kirtonBCIlab/boccia-hardware-firmware/(threads)

Thread 13 (2023-05-05):

Force sensor

danielcomaduran, 2023-05-05:
Mount force sensor on the bottom of the ramp. Use a foam-like material that can deform a little bit before mechanical failure occurs.

Thread 14 (2023-05-05):

Release mount redesign

danielcomaduran, 2023-05-05:
Redesign the holder for the release mechanism so that it can house one optical sensor at the lower end

Thread 15 (2023-05-05):

Multiple sensors

danielcomaduran, 2023-05-05:
Modify the stepper motor object so that we can use two separate sensors for the calibration. This would allow us to know which side is activated. Make sure that the implementation still makes use of the interrupts

Closed 2023-07-24.

Thread 17 (2023-05-05):

Change base for hard wood

danielcomaduran, 2023-05-05:
Or add some support material so that the wood doesn't deform because of the tension caused by the belt attached to the rotation motor

Thread 18 (2023-05-05):

Release mechanism

danielcomaduran, 2023-05-05:
Write a method in the stepper motor that controls the mechanism to open the lever. The lever should have an optical sensor on the lower side before mechanical failure. The movement flow should be as follows:

- Have the lever move until the sensor is active, this will be set to position 0.
- When the respective serial command is received, have the motor move `x` number of steps up to allow the ball to drop.
- Return the motor to the 0 position.
- Make sure that x is an input variable to the method so that it can be adjusted by trial and error

Closed 2023-07-20.

Thread 9 (2023-05-05):

Variable to set correct direction of linear actuators

danielcomaduran, 2023-05-05:
The linear actuators are soldered in different orientations (i.e., one extends with the same command that retracts the other). This is due to the cabling of the driver being reversed. Create an attribute in the linear actuator object that addresses this issue

Thread 25 (2023-05-25):

Incline actuator extending too much

danielcomaduran, 2023-05-25:
The way that the incline actuator is mounted right now, it can extend to a point where the front of the ramp will hit the floor

Closed 2023-07-24.

Thread 31 (2023-06-30):

Update schematic with LPF

danielcomaduran, 2023-06-30:
Update the schematic files to include the low-pass filter that was added to the optical sensors.
Values for the filter are: 15 kOhms y 1 nF

Closed 2023-07-13.

Thread 37 (2023-07-14):

Sensor test

danielcomaduran, 2023-07-14:
Sensor is moved to analog pin 7, do not use interrupt any more.

Muhammad
- Do a test function to read the value of the pressure sensor and print in Serial

Dan
- In main code do this: check for sensor analog value while moving motor, if threshold is passed, stop movement and return a bit

Closed 2023-07-20.

Thread 39 (2023-07-20):

Skipping Steps

MuhammadFAns, 2023-07-20:
Both motors are skipping steps

Closed 2023-07-31.

Thread 42 (2023-07-24):

Pressure sensor hold mechanism

danielcomaduran, 2023-07-24:
The foam used to secure the pressure sensor to the bottom of the ramp is too wide, if the ramp does not contact the ground right under the sensor, the foam deforms but the sensor does not get activated. Some solutions are:
1. Change the foam for a narrower foam that just covers the sensor and not the whole back of the ramp
2. Design a completely new mechanism to secure the pressure sensor to the ramp.

Thread 43 (2023-07-24):

Redo incline motor attachment mechanism

danielcomaduran, 2023-07-24:
With the current mechanism,
1. The incline motor can continue to push after the ramp has touched the ground; the 3D printed parts deform, and the motor pushed backwards instead of upwards.
2. The ramp has a lot of play to the sides

Thread 45 (2023-07-24):

Fix the return steps for BocciaStepper()

danielcomaduran, 2023-07-24:
Fix the return steps so that it automatically clears the sensor, instead of having to use the `nsteps_return` attribute.

danielcomaduran, 2023-08-01:
I tried this and it does not work. The problem is that since the motor only takes one step at a time, the movement is quite slow and it doesn't seem smooth. It is better to keep the `nsteps_return` option.

Closed 2023-08-01.

Thread 63 (2024-03-01):

Change linear actuator to control to PID controller

danielcomaduran, 2024-03-01:
Change the current controller method of the linear actuators to use a PID controller.

Here is one starting point:
```
// Define your tuning parameters (you can adjust these)
double kp = 0.1; // Proportional gain
double ki = 0.01; // Integral gain
double kd = 0.001; // Derivative gain

// Initialize variables
unsigned long lastTime = 0;
double Input = 0.0; // Sensor input (e.g., temperature, position)
double Output = 0.0; // Control output (e.g., motor speed)
double Setpoint = 100.0; // Desired setpoint (adjust as needed)
double errSum = 0.0; // Integral term
double lastErr = 0.0; // Previous error

void Compute() {
    // Calculate time since last computation
    unsigned long now = millis();
    double timeChange = (double)(now - lastTime);

    // Compute error terms
    double error = Setpoint - Input;
    errSum += (error * timeChange);
    double dErr = (error - lastErr) / timeChange;

    // Compute PID output
    Output = kp * error + ki * errSum + kd * dErr;

    // Remember variables for next iteration
    lastErr = error;
    lastTime = now;
}

void SetTunings(double Kp, double Ki, double Kd) {
    // Set new tuning parameters
    kp = Kp;
    ki = Ki;
    kd = Kd;
}

void setup() {
    // Initialize your hardware (e.g., sensors, actuators)
    // Set initial setpoint and other parameters
}

void loop() {
    // Read sensor input (e.g., analogRead, digitalRead)
    Input = /* Read your sensor value here */;

    // Compute PID output
    Compute();

    // Apply the control output (e.g., analogWrite, digitalWrite)
    // Adjust your motor speed or other actuator accordingly
}
```
