kirtonBCIlab/boccia-hardware-firmware/Electronics/Boccia-controller/controller.sch

## EAGLE design Electronics/Boccia-controller/controller.sch (2023-07-13)

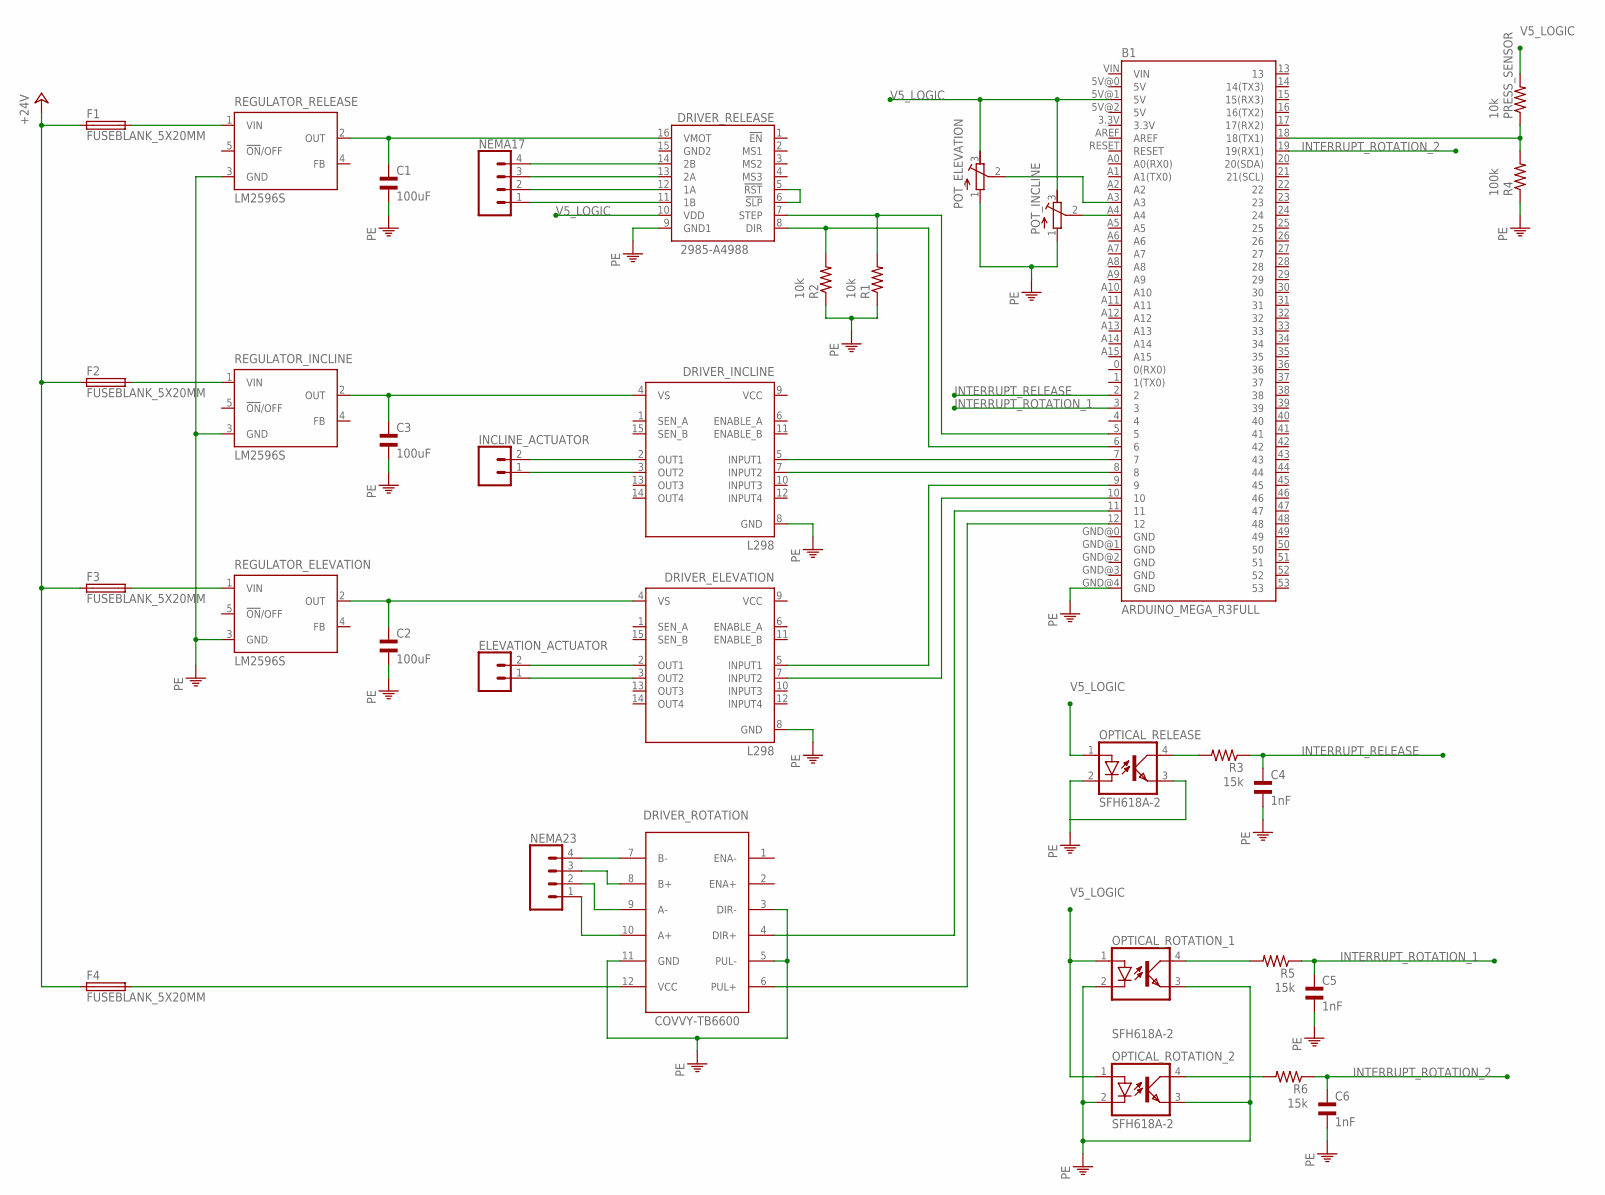
[picture p1: schematic controller.sch]

Parts:
B1: ARDUINO_MEGA_R3FULL; ARDUINO_MEGA
C1, C2, C3: 100uF; EU35-12
C4, C5, C6: 1nF; EU35-12
DRIVER_ELEVATION: L298; MULTIWATT-15
DRIVER_INCLINE: L298; MULTIWATT-15
DRIVER_RELEASE: 2985-A4988; A4988
DRIVER_ROTATION: COVVY-TB6600; COVVY_TB6600
ELEVATION_ACTUATOR: CONN_02; 1X02
F1, F2, F3, F4: FUSEBLANK_5X20MM; FUSE_HOLDER_5X20MM
INCLINE_ACTUATOR: CONN_02; 1X02
NEMA17, NEMA23: CONN_04; 1X04
OPTICAL_RELEASE: SFH618A-2; DIP4
OPTICAL_ROTATION_1, OPTICAL_ROTATION_2: SFH618A-2; DIP4
POT_ELEVATION: R-TRIMM64X; RTRIM64X
POT_INCLINE: R-TRIMM64X; RTRIM64X
PRESS_SENSOR: 10k; R0805
R1, R2: 10k; R0805
R3, R5, R6: 15k; R0805
R4: 100k; R0805
REGULATOR_ELEVATION: LM2596S; TO263-5
REGULATOR_INCLINE: LM2596S; TO263-5
REGULATOR_RELEASE: LM2596S; TO263-5

Connections:
+24V: F1.1, F2.1, F3.1, F4.1
INTERRUPT_RELEASE: B1.2, C4.1, R3.1
INTERRUPT_ROTATION_1: B1.3, C5.1, R5.1
INTERRUPT_ROTATION_2: B1.19 (19(RX1)), C6.1, R6.1
unnamed: B1.18 (18(TX1)), PRESS_SENSOR.1, R4.2
unnamed: DRIVER_ROTATION.7 (B-), NEMA23.4
unnamed: DRIVER_ROTATION.8 (B+), NEMA23.3
unnamed: DRIVER_ROTATION.9 (A-), NEMA23.2
unnamed: DRIVER_ROTATION.10 (A+), NEMA23.1
unnamed: F2.2, REGULATOR_INCLINE.1 (VIN)
unnamed: B1.A3, POT_ELEVATION.2 (S)
unnamed: B1.A4, POT_INCLINE.2 (S)
unnamed: DRIVER_ELEVATION.2 (OUT1), ELEVATION_ACTUATOR.2
unnamed: DRIVER_ELEVATION.3 (OUT2), ELEVATION_ACTUATOR.1
unnamed: DRIVER_INCLINE.2 (OUT1), INCLINE_ACTUATOR.2
unnamed: DRIVER_INCLINE.3 (OUT2), INCLINE_ACTUATOR.1
unnamed: C2.1, DRIVER_ELEVATION.4 (VS), REGULATOR_ELEVATION.2 (OUT)
unnamed: C3.1, DRIVER_INCLINE.4 (VS), REGULATOR_INCLINE.2 (OUT)
unnamed: DRIVER_RELEASE.14 (2B), NEMA17.4
unnamed: DRIVER_RELEASE.13 (2A), NEMA17.3
unnamed: DRIVER_RELEASE.12 (1A), NEMA17.2
unnamed: DRIVER_RELEASE.11 (1B), NEMA17.1
unnamed: DRIVER_RELEASE.5 (!RST), DRIVER_RELEASE.6 (!SLP)
unnamed: B1.10, DRIVER_ELEVATION.7 (INPUT2)
unnamed: B1.9, DRIVER_ELEVATION.5 (INPUT1)
unnamed: B1.8, DRIVER_INCLINE.7 (INPUT2)
unnamed: B1.7, DRIVER_INCLINE.5 (INPUT1)
unnamed: B1.6, DRIVER_RELEASE.8 (DIR), R2.2
unnamed: B1.5, DRIVER_RELEASE.7 (STEP), R1.2
unnamed: OPTICAL_RELEASE.4 (COL), R3.2
unnamed: F1.2, REGULATOR_RELEASE.1 (VIN)
unnamed: DRIVER_ROTATION.12 (VCC), F4.2
unnamed: F3.2, REGULATOR_ELEVATION.1 (VIN)
unnamed: OPTICAL_ROTATION_1.4 (COL), R5.2
unnamed: OPTICAL_ROTATION_2.4 (COL), R6.2
unnamed: B1.11, DRIVER_ROTATION.4 (DIR+)
unnamed: B1.12, DRIVER_ROTATION.6 (PUL+)
PE: B1.GND@4 (GND), C1.2, C2.2, C3.2, C4.2, C5.2, C6.2, DRIVER_ELEVATION.8 (GND), DRIVER_INCLINE.8 (GND), DRIVER_RELEASE.9 (GND1), DRIVER_ROTATION.3 (DIR-), DRIVER_ROTATION.5 (PUL-), DRIVER_ROTATION.11 (GND), OPTICAL_RELEASE.2 (C), OPTICAL_RELEASE.3 (EMIT), OPTICAL_ROTATION_1.2 (C), OPTICAL_ROTATION_1.3 (EMIT), OPTICAL_ROTATION_2.2 (C), OPTICAL_ROTATION_2.3 (EMIT), POT_ELEVATION.1 (A), POT_INCLINE.1 (A), R1.1, R2.1, REGULATOR_ELEVATION.3 (GND), REGULATOR_INCLINE.3 (GND), REGULATOR_RELEASE.3 (GND)
V5_LOGIC: B1.5V@1 (5V), DRIVER_RELEASE.10 (VDD), OPTICAL_RELEASE.1 (A), OPTICAL_ROTATION_1.1 (A), OPTICAL_ROTATION_2.1 (A), POT_ELEVATION.3 (E), POT_INCLINE.3 (E), PRESS_SENSOR.2
V12_NEMA17: C1.1, DRIVER_RELEASE.16 (VMOT), REGULATOR_RELEASE.2 (OUT)
