kirtonBCIlab/boccia-hardware-firmware/Stepper_feedback_control/Stepper_feedback_control.ino

/*
 * Stepper Feedback Control
 */


// Sensor variables
const int pin_sense = A0;
const float analog_threshold = 2; // Analog reading threshold [V]
bool limit_trigger = 0;

// Stepper motor variables
#include <AccelStepper.h>

const int pin_dir = 3;  // Direction pin
const int pin_step = 2; // Step pin
int lim0;               // Lower limit of the stepper motor [steps]
int lim1;               // Higher limit of the stepper motor [steps]
int range;              // Range of movement of the stepper [steps]

// - Create stepper object
AccelStepper nema8(AccelStepper::DRIVER, pin_step, pin_dir);

void setup() {
  Serial.begin(9600);

  // Set stepper parameters
  nema8.setMaxSpeed(1000);    // Maximum speed [steps/sec]
  nema8.setAcceleration(10);  // Acceleration [steps/sec^2]
  nema8.setSpeed(400);        // Speed [steps/sec]
  range = 0;                  // Range of motion of calibrated motor [steps]

  Serial.println("Select command:\n - c: calibration\n - m: move");
}

void loop() {
  if(Serial.available() > 0)
  {
    char answer = Serial.read();
    
    // Flush buffer
    for(int i=0; i<Serial.available(); i++)
    { Serial.read();  }
    
    
    if(answer=='c')
    {
      calibrationProcess();
      Serial.println("Select 'm' to move");
    }
    else if(answer=='m')
    {
      Serial.println("How many steps to move?");

      while(Serial.available()<=1)
      {
        waitMillis(100);
      }
      int steps = Serial.parseInt();
      moveProcess(lim0, lim1, steps); 
    }
    else
    {}
  }
  


}

// Move stepper only within limits
void moveProcess(int lim0, int lim1, int move_steps)
{
  int current_position = nema8.currentPosition();
  Serial.println("Current pos: " + String(current_position));
  Serial.println("How many steps requested? " + String(move_steps));
  int new_position = current_position + move_steps;
  Serial.println("Calculated new pos: " + String(new_position));

  if((new_position < lim0) && (new_position > lim1))
  {
    moveStepper(move_steps);
  }
  else if (new_position > lim0)
  {
    move_steps = lim0 - current_position;
    moveStepper(move_steps);
  }
  else if (new_position < lim1)
  {
    move_steps = lim1 - current_position;
    moveStepper(move_steps);
  }
  else
  {
    Serial.println("No need to move, already at limit!");
  }
  Serial.println("Actual position after movement " + String(nema8.currentPosition()));
}

void calibrationProcess()
{
  Serial.println("Calibration started");
  
  waitMillis(1000);
  lim0 = calibrateStepper(1);
  Serial.println("Lower limit found");
  Serial.println("Stepper position: " + String(lim0));
  
  waitMillis(1000);  
  lim1 = calibrateStepper(-1);
  Serial.println("Upper limit found");
  Serial.println("Stepper position: " + String(lim1)); 

  Serial.println("Range: " + String(abs(lim1-lim0)));
  Serial.println("Calibration finished\n");
}

// Calibrate stepper motor and return position 
int calibrateStepper(int stepper_direction)
{
  float analog_value;
  do
  {
    nema8.move(5*stepper_direction);
    nema8.run();
    analog_value = analogReader(pin_sense);
  }while(analog_value < analog_threshold);

  int stepper_lim = nema8.currentPosition();
  return stepper_lim;
}

void moveStepper(int steps)
{
  nema8.move(steps);
  while(nema8.distanceToGo() != 0)
  {    
    nema8.run();
  }
}

// Read analog pin and convert to V
float analogReader(int analog_pin)
{
  float analog_digital = analogRead(analog_pin);
  float analog_volts = analog_digital * 5 / 1024;
  return analog_volts;
}

void waitMillis(unsigned long wait_msec)
{
    unsigned long deltaT, t0, t1 = 0;
    t0 = millis();
    
    do
    {
      t1 = millis();
      deltaT = t1-t0;
    }while(deltaT < wait_msec);
}
