kirtonBCIlab/boccia-hardware-firmware/Examples/LED_test/LED_test.ino

void setup() {
  // Initialize LEDs
  pinMode(3, OUTPUT);
  pinMode(LED_BUILTIN, OUTPUT);

}

void loop() {
  digitalWrite(LED_BUILTIN, HIGH);   // turn the LED on (HIGH is the voltage level)
  delay(2000);                       // wait for a second
  digitalWrite(LED_BUILTIN, LOW);    // turn the LED off by making the voltage LOW
  delay(1000);                       // wait for a second

  digitalWrite(3, HIGH);   // turn the LED on (HIGH is the voltage level)
  delay(1000);                       // wait for a second
  digitalWrite(3, LOW);    // turn the LED off by making the voltage LOW
  delay(1000);                       // wait for a second

}
