kirtonBCIlab/boccia-hardware-firmware/(commit log)

2022-07-20 Create LED_test.ino
    Simple script to turn built-in and external LEDs
2022-08-04 Uploaded sketch for actuator simple control
2022-08-11 Uploaded sketch for stepper motor without libraries
2022-08-12 Uploaded simple controller for stepper motor
2022-08-17 Sketch to control the stepper through serial communication
2022-08-18 Uploaded stepper feedback sketch
    Sketch that allows for calibration of the stepper motor using the optical sensor. Then one can input how many steps to move within the calibrated range
2022-09-15 OOD Example
    Uploaded initial commit for Object Oriented Example with Interrupts working
2022-09-22 implemented interrupt limit for decceleration
2022-09-22 Added calibration prints
2022-10-03 Small tweaks on linear stepper
2022-10-27 Added conversion between percentage and resistance
2022-10-28 Added error message for wrong command
    [main.cpp]
2022-10-28 Fixed motor selection
2022-11-04 Fixed bug linear actuator over limits
    [main.cpp]
2022-11-04 Implement acceleration on linear actuator
2022-12-13 Created folders and files for mixed motor
2022-12-13 Changed pin to potentiometer and added sensor variable
2022-12-14 Added warning to actuator movement over or under limits
2022-12-14 Digital debounce func and calibration with sensor
2022-12-21 Added elevator actuator object
2022-12-21 Changed direction of motors
2022-12-21 Added elevator actuator
2023-02-28 Deleted repeated elevator actuator
2023-02-28 Changed name of motors and minor fixes
    [main.cpp]
2023-04-17 Minor comments to fix
    [main.cpp]
2023-05-17 Added a few lines of description to Boccia stepper
2023-06-16 Uploaded electronics schematics
    [controller.sch]
2023-06-16 Added test sketch for testing the linear actuators
2023-06-16 Changed incline pot pin value
2023-06-16 Updated calibration test sketch
2023-06-16 Added check for sensor to fix calibration
2023-06-16 Updated electronics schematics
    [controller.sch]
2023-06-30 Added pin number
2023-06-30 check point with errors
    [main.cpp]
2023-07-04 Implemented OOP for stepper
2023-07-11 Save point, issue with release interrupts
    [Stepper_feedback_interrupt_control.ino, Stepper_library_hello_world.ino, main.cpp]
2023-07-12 Check point not working
    [Stepper_feedback_interrupt_control.ino, main.cpp]
2023-07-13 Modified example file to test stepper motors
2023-07-13 Updated new files with filters for optical sensors
    [controller.sch]
2023-07-13 Checkpoint without the optical sensors enabled
2023-07-13 Stepper OOP finished with sensor
2023-07-18 Release Sensor
2023-07-19 Checkpoint with actuators working
2023-07-19 Linear actuators working
2023-07-19 Uncommented calibrations
2023-07-19 CHeck point, release mechanism not working
    [main.cpp]
2023-07-20 Changed functions slightly for interrupt
2023-07-20 Changes direction when sensor is active
2023-07-20 Added movement if sensors blocked
2023-07-24 Clear Sensor Added to Code
2023-07-24 Added the gear_ratio attribute to BocciaStepper
2023-07-25 Not working, some notes added
    [main.cpp]
2023-07-25 Deg conversion ready, missing gear ratio
    [main.cpp]
2023-07-26 Changed interrupt values
2023-07-28 Removed unnecessary print statements
2023-07-28 Fixed release calibration direction
    [main.cpp]
2023-08-03 Fixed indentation in main
    [main.cpp]
2023-08-08 Added moveToMiddle() and edited switches
2023-08-08 Changed switches and added moveToMidpoint()
2023-08-08 Added moveToMidpoint() and changed switches
2023-08-09 Changed calibration to case 8
2024-03-13 Arduino file to test PID controller. Calibrates and moves to middle
